Papipapito/MSXgoauldSD_usbkb/README.md

# MSXgoauldSD_usbkb — MSX Goa'uld with USB keyboard & joystick

Fork of **[jabadiagm/MSXgoauldSD_tn20k](https://github.com/jabadiagm/MSXgoauldSD_tn20k)** — the FPGA "Z80-socket replacement" that turns a real MSX into an MSX2+ on a Tang Nano 20K — adding a **USB keyboard and a USB joystick/gamepad** that work **alongside** the MSX's own keyboard and joysticks, through a **Raspberry Pi Pico / RP2040** over a single UART wire. Everything the MSX already does (real keyboard, joysticks, cartridges, SD, WiFi) keeps working; the USB devices are *merged in*, not a replacement.

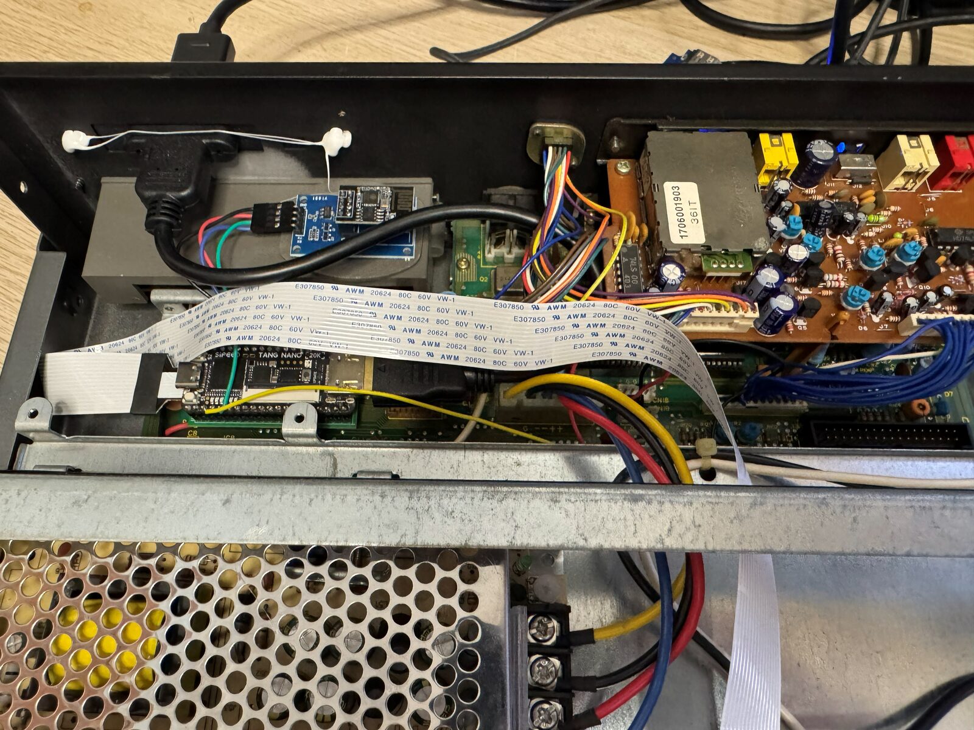
[picture p1: pics/goauld_usbkb_in_msx.jpg]
The Goa'uld board (Tang Nano 20K) installed in a real MSX, with the ESP-01S WiFi module


*The Goa'uld board (Sipeed **Tang Nano 20K**) sitting in a real MSX's Z80 socket, with the **ESP-01S WiFi** module and HDMI output. The USB keyboard and joystick reach the FPGA over the single wire to Tang pin 75 — the MSX's own keyboard and joysticks keep working at the same time.*

▶️ **See it running on a real MSX:**

MSXgoauldSD_usbkb — USB keyboard on a real MSX (video) (https://youtube.com/shorts/J3gg5tnaye4)

**Derived from the great work of:**
- **jabadiagm** — MSX Goa'uld: the FPGA MSX2+ core and board. <https://github.com/jabadiagm/MSXgoauldSD_tn20k>
- **Chandler-Klüser** — MSX Goa'uld *Guardian Angel*: the RP2040 USB-host firmware (based on the No0ne / pdaxrom HID parser). <https://github.com/Chandler-Kluser/msx-goauld-ga>
- **Ryan Wendland (Ryzee119)** — `tusb_xinput`, the TinyUSB XInput host driver (MIT). <https://github.com/Ryzee119/tusb_xinput>

**License:** GPLv3 (inherited). The vendored `tusb_xinput` driver keeps its MIT header.

## Features
- **USB keyboard** alongside the physical MSX keyboard — **US / International** layout, non-blocking make/break, modifiers (Shift/Ctrl/Graph/Code).
- **USB joystick / gamepad** merged with the real MSX joysticks — **generic HID *and* XInput (Xbox)** pads.
- **One data wire**: RP2040 → FPGA over UART (Tang Nano pin 75). The joystick needs no extra pins (same link).
- **WS2812 status LED** on the RP2040 (red / green / yellow / white), plus an optional external 8-LED status panel.
- **Turbo** — internal high-speed CPU, toggled from the boot menu, **F11**, or the Panasonic `$40/$41` I/O ports.
- **WiFi (ESP-01S)** ready in the FPGA core (optional).
- Real keyboard, joysticks, slots and cartridges are untouched.

## How it works
The Goa'uld board replaces the MSX's Z80, so the FPGA sits on the real system bus. It does **not** re-implement the keyboard/joystick ports — the real motherboard scans them and the FPGA just *watches* the bus. The RP2040 runs a TinyUSB **host**, reads the USB keyboard + gamepad, and sends keyboard **make/break** events (plus a periodic full-matrix resync) and a **joystick byte** (`0xB0 <port> <state>`) over UART. Inside the FPGA these are **AND-merged** (active-low) into the MSX keyboard-matrix read and the PSG joystick read, so the **USB and the real devices coexist** — use either, both reach the MSX.

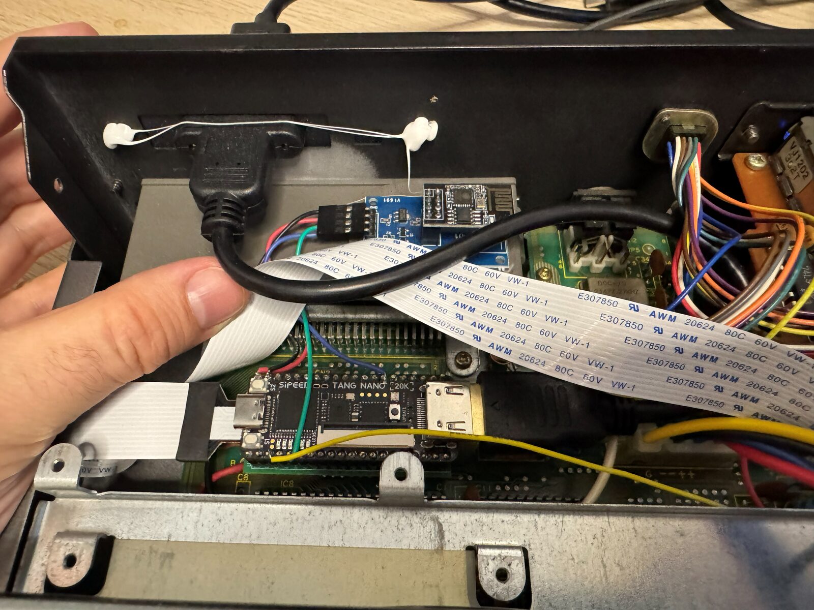
[picture p2: pics/goauld_usbkb_tang_hdmi.jpg]
Close-up of the Tang Nano 20K with HDMI output and the ESP-01S WiFi module


*Close-up: the **Tang Nano 20K** (HDMI out, USB-C) and the **ESP-01S WiFi** module, connected to the Z80 socket by the ribbon cable.*

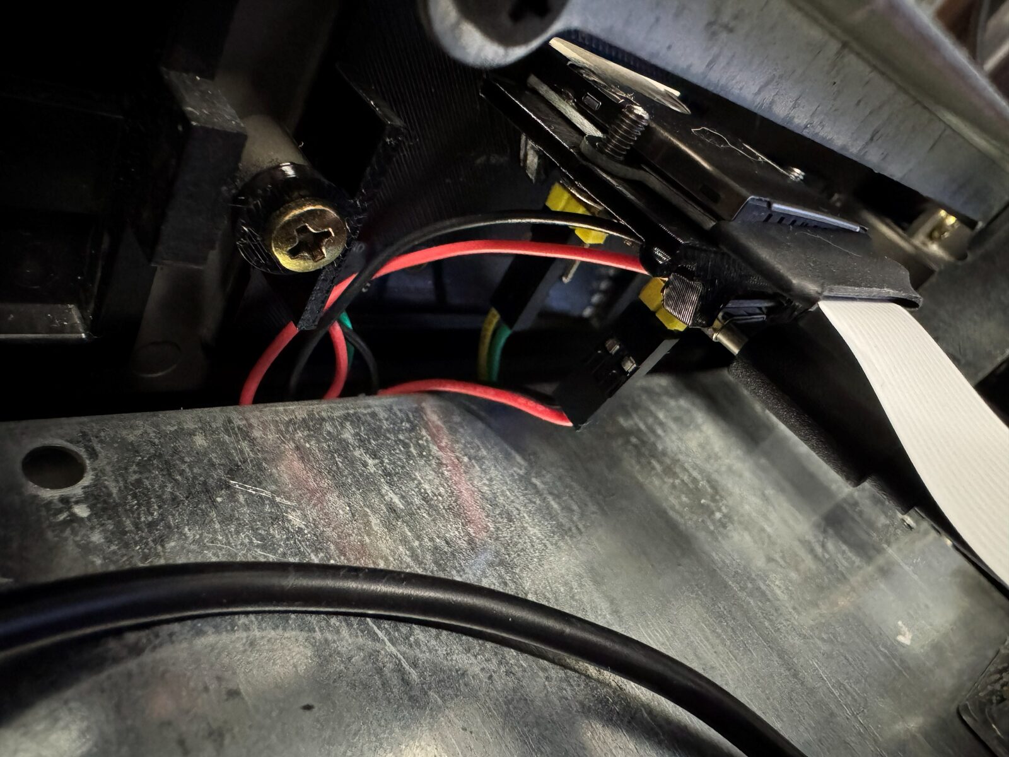
[picture p3: pics/goauld_usbkb_rp2040_leds.jpg]
The RP2040-Zero and the back of the case's front LED panel


*The **RP2040-Zero** (running the USB keyboard/joystick firmware) and the rear of the case's **front LED status panel** (the WS2812 strip).*

## Binaries (see [Releases](../../releases) or [`production/`](production/))
| File | What it is |
|---|---|
| `MSXgoauldSD_usbkb.fs` | FPGA bitstream (Tang Nano 20K, GW2AR-18) with the keyboard + joystick merge. |
| `rp2040_keyboard.uf2` | RP2040 firmware — **Waveshare RP2040-Zero** (on-board WS2812 LED on GPIO16). |

> The release ships the **RP2040-Zero** firmware. A plain **Raspberry Pi Pico** build (mono LED on GPIO25) can be built from source with `-DRP2040_ZERO=0`. Both drive the optional external 8-LED WS2812 panel on **GP26** (see *Status LEDs*).

## Version guard (keep the three flashables in step)
Since **v1.2**, the bitstream, the RP2040 firmware and the BIOS pack all carry the **same BCD version** (e.g. `0x13` = v1.3) and the **FPGA verifies it**:

- **`.fs`** — `FPGA_VERSION` in [`fpga/top.v`](fpga/top.v).
- **`.uf2`** — `FW_VERSION` in [`rp2040/inc/usbin.h`](rp2040/inc/usbin.h); the RP2040 announces it over the UART link (`0xC0 <ver>`, re-sent with every 250 ms resync — old bitstreams simply ignore it).
- **BIOS pack** — the **last byte** of the 512 KB pack (offset `0x7FFFF`, flash `0x27FFFF`); the FPGA latches it while loading the pack at boot. Packs that predate v1.2 read `0xFF` there.

**Automatic warning (no software needed):** if the versions do **not** match — e.g. you flash a new `.fs` but keep an old BIOS pack, or run a firmware from another version — the FPGA paints a **thick red border around the screen** while the machine runs. It disappears as soon as all three match. The RP2040 is optional: with **no Pico connected** there is **no border** (only a *mismatched* Pico or an *old pack* triggers it).

For scripted checks, the FPGA also exposes everything on I/O ports **0x2E/0x2F** (reads are served by the FPGA only; same `0x2F` convention as MSXnano):

| Access | Returns |
|---|---|
| `IN &H2F` | FPGA version (e.g. `&H13`) |
| `OUT &H2F,0` then `IN &H2E` | RP2040 firmware version (`0` = not announced / link down) |
| `OUT &H2F,1` then `IN &H2E` | BIOS pack version byte (`&HFF` = pre-v1.2 pack) |
| `OUT &H2F,2` then `IN &H2E` | **Verify status: `0` = everything matches**; bit0 = uf2 mismatch, bit1 = uf2 not announced, bit2 = pack mismatch, bit3 = pack has no version |

Quick check from MSX-BASIC:
```basic
OUT &H2F,2 : IF INP(&H2E)=0 THEN PRINT "VERSIONS OK" ELSE PRINT "MISMATCH! ";INP(&H2E)
```
When releasing, bump `FPGA_VERSION`, `FW_VERSION` and the pack byte **together**.

## Status LEDs (WS2812)

### On-board LED (RP2040-Zero)
A single WS2812 showing one **priority** colour:
| Colour | Meaning |
|---|---|
| 🔵 Blue blink (3×) at power-up | Firmware booted OK |
| 🔴 Solid red | Alive — nothing connected |
| 🟢 Solid green | USB **keyboard** connected |
| 🟡 Solid yellow | USB **gamepad** connected |
| ⚪ White flash | Key press / joystick activity |

### Optional external 8-LED panel (on the case)
An 8× WS2812 stick mounted on the case turns the status into a **panel where each LED is a different signal** (instead of one colour). Driven from **RP2040 GP26**; the on-board LED keeps working alongside it.

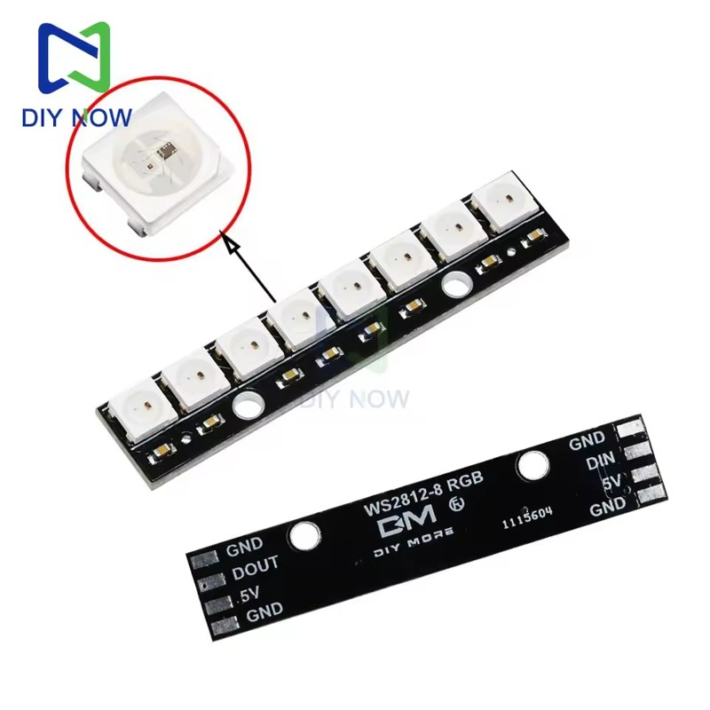
[picture p4: pics/ws2812_8_strip.jpg]
WS2812-8 RGB strip


**Board:** a generic **WS2812-8 RGB** stick (8 × WS2812 / NeoPixel on a PCB) — e.g. [AliExpress (product 1005009810895755)](https://www.aliexpress.com/item/1005009810895755.html).

**Pinout** — two pad rows; **use the `DIN` side** (the `DOUT` side just chains a second strip):

| Side | Pads |
|---|---|
| **Input (use this)** | `GND` · **`DIN`** · `5V` · `GND` |
| Output (chain) | `GND` · `DOUT` · `5V` · `GND` |

**Wiring** — the strip is rated **4–7 VDC**:
```
RP2040 GP26  ->  strip DIN    (3.3 V data, direct -- no level shifter)
common GND   ->  strip GND
MSX +5V --|>|-   strip 5V      one 1N4007 silicon diode -> ~4.3 V (inside the
                               4-7 V range). The strip's VIH (~0.7*Vcc) then sits
                               below 3.3 V, so it reads the RP2040's 3.3 V data.
                               5 V direct often works too -- add the diode only
                               if the colours glitch.
```

**What each LED means** — LED **0** is the one nearest the `DIN` connector:

| # | Colour | Signal |
|---|---|---|
| 0 | 🔴 red | **Power** — system on (always lit) |
| 1 | 🔵 blue | USB **keyboard** detected |
| 2 | 🟡 yellow | USB **gamepad** detected |
| 3 | ⚪ white | **Typing** — flashes on key press |
| 4 | 🟢 green | **Fire A** / button 1 (blinks at 10 Hz while autofiring) |
| 5 | 🟣 magenta | **Fire B** / button 2 (blinks at 10 Hz while autofiring) |
| 6 | 🩵 cyan | **Direction** — any joystick movement |
| 7 | 💚 dim green | **Heartbeat** (~1 Hz, shows the firmware is alive) |

> To change the data pin, the LED order or the colours, edit `STRIP_PIN` / the `f[...]` lines in [`rp2040/src/main.c`](rp2040/src/main.c). `STRIP_LEDS` defaults to 8.

## Flashing (both files)
1. **FPGA** — Gowin Programmer → load `MSXgoauldSD_usbkb.fs` into the Tang Nano 20K (SRAM for a quick test, or the external config flash to persist). Your BIOS pack at `0x200000` is untouched.
2. **RP2040** — hold **BOOTSEL**, plug USB-C → the `RPI-RP2` drive appears → copy `rp2040_keyboard.uf2` onto it. The blue boot blink = it's running.

## USB keyboard
**US / International** layout (matches the international MSX2+ BIOS). Letters, digits and arrows are 1:1 with the MSXnano translator; a few symbols depend on your board's BIOS. The MSX BIOS does autorepeat and the FPGA owns the matrix, so the RP2040 never blocks.

## USB joystick / gamepad
Plug a **wired** USB pad into the RP2040 (use a **powered** USB hub if you also want the keyboard at the same time). Mapped to **MSX joystick port 1**: D-pad / hat / left stick → directions, **A / button 1 → fire 1 (trigger A)**, **B / button 2 → fire 2 (trigger B)**. The two spare buttons (3 / 4) act as **autofire** for fire 1 / fire 2.
- **XInput** — Xbox 360 / One / Series and XInput-mode pads (via the bundled `tusb_xinput` driver). ✅ tested on hardware.
- **Generic HID** — pads exposing standard X/Y axes, a hat and buttons (many retro / arcade / SNES-style USB pads).
- **Keyboard + joystick at once** need a **powered** USB hub — the RP2040-Zero has a single USB port. Since v1.3 an XInput pad runs **input-only** (rumble / LED are disabled): its extra interrupt-OUT endpoint otherwise overwhelms the RP2040's native USB host behind a hub and stops both devices from working.
- **Limitations:** wireless **2.4 GHz dongles** usually can't be enumerated by the RP2040's lightweight USB host (they signal late, after the pad pairs) → use a **wired** controller; some **DualShock 4 / PS-mode** pads use a report format the basic HID parser doesn't decode yet → use the pad in **XInput mode** if it has one.

## Turbo (high-speed CPU)
The core has an internal **high-speed CPU clock** — jabadiagm's ~6.75 MHz turbo, derived from the video clock so it stays stable at boot, in the menu and in MSX-DOS. Since **v1.3** there are **three ways** to toggle it, all acting on the same state:

- **Boot menu** — the *Turbo* option (press **G** during the MSX logo).
- **F11** — toggles turbo **live** at any moment, from the USB keyboard.
- **Panasonic switched-I/O ports `$40/$41`** (device 8, WSX-style) so existing MSX turbo software works unchanged:
  ```basic
  OUT &H40,8 : PRINT INP(&H40)  ' select device 8; returns 247 (detection)
  OUT &H41,0                    ' turbo ON   (bit0 active-low)
  OUT &H41,1                    ' turbo OFF
  ' INP(&H41) = 250 (&HFA) turbo / 251 (&HFB) normal
  ```

> Turbo runs the CPU faster than real-MSX timing; some timing-sensitive software may misbehave — use it for SD / MSX-DOS work and games that tolerate it.

## Wiring (one data wire + ground + 5 V)

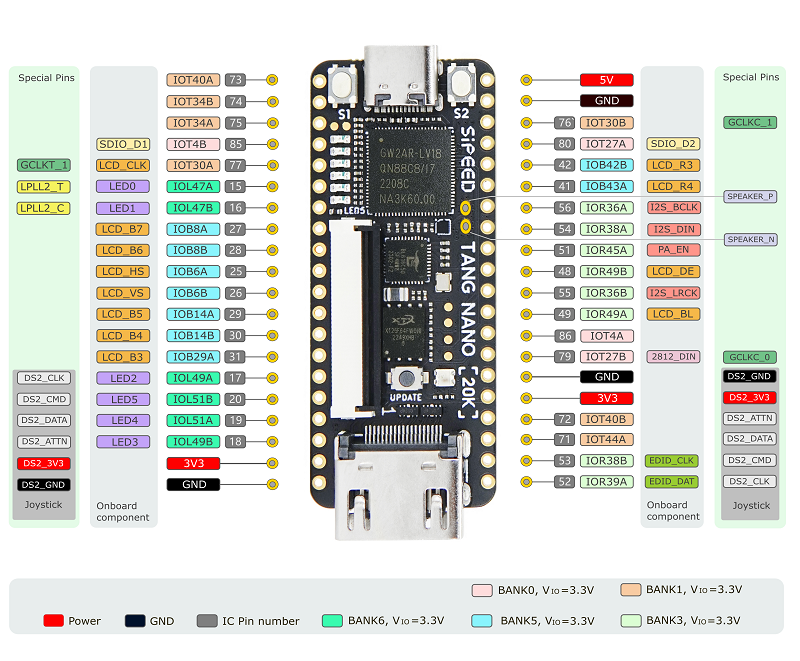
[picture p5: pics/tang_nano_20k_pinout.png]
Tang Nano 20K pinout


*Tang Nano 20K pin labels — image © [Sipeed](https://wiki.sipeed.com/hardware/en/tang/tang-nano-20k/nano-20k.html).* **The pins this fork uses:**

| Tang Nano 20K pin | Used for | Direction |
|---|---|---|
| 🟢 **75** | RP2040 keyboard **+ joystick** link | RP2040 GP15 (PIO-UART TX) → FPGA |
| 🔵 **77** | WiFi — ESP-01S (optional) | ESP TX → FPGA |
| 🔵 **79** | WiFi — ESP-01S (optional) | FPGA → ESP RX |
| ⚫ **GND** | Common ground (required) | — |
| 🔴 **5V** | Power | MSX +5 V → RP2040 / ESP |

```
RP2040 GP15 (PIO-UART TX) ->  Tang Nano 20K pin 75
RP2040 GND                ->  Tang Nano 20K GND   (common ground, required)
RP2040 VBUS / 5V          ->  MSX +5V
USB keyboard / gamepad    ->  RP2040 USB host port (use a powered hub for both at once)
```
UART **115200 8N1**, data flows RP2040 → FPGA only; 3.3 V LVCMOS both ends (no level shifter). Since v1.3 the link is driven from **GP15** via a PIO UART (the LED strip uses GP26, GP27 is free) — the RP2040's hardware UARTs don't reach GP15.

### WiFi (ESP-01S, optional)
The core ships with the MSX UNAPI WiFi driver. Wire an **ESP-01S**: TX → **pin 77**, RX → **pin 79**, VCC + CH_PD → **3.3 V**, GND → GND. Firmware: the **OCM** build of **[ducasp / MSX-Development ESPFW1.4](https://github.com/ducasp/MSX-Development/releases/tag/ESPFW1.4)**; baud **859372**, I/O ports **0x06 / 0x07**. It coexists with the RP2040 (pin 75).

## Building from source
- **FPGA:** open `Z80_goauld.gprj` in Gowin EDA, run synthesis + place-and-route → `MSXgoauldSD_usbkb.fs`. The USB logic is in [`fpga/src/kbd_uart_rx.v`](fpga/src/kbd_uart_rx.v) and the bus merge in [`fpga/top.v`](fpga/top.v).
- **RP2040:** standard pico-sdk build in [`rp2040/`](rp2040/) — `cmake -B build && cmake --build build`. Set `PICO_SDK_PATH` to your pico-sdk; pass `-DRP2040_ZERO=0` for a plain Pico.

The MSX **BIOS pack** and any third-party module firmware are **not** distributed here (copyright).

---

# MSXgoauldSD_tn20k
MSX Goa'uld board with Tang Nano 20k and SD support

V1.5_SMD

MSX2+ engine in Z80 socket. It turns one MSX into an MSX2+ by replacing Z80 processor. FPGA in board contains: 
* Z80
* V9958 with hdmi output
* MSX2+ BIOS
* SD Card support + Nextor 2.1
* 4MB mapper
* 2MB megaram SCC
* RTC
* PSG
* OPLL
* Kanji Level 1 & 2
* Wifi support using ESP (experimental)

## Boards

Old boards V1.4 and V4.1 are compatible with Goa'uld SD. V3 is not supported, owners of V3 should use Goa'uld standard firmware (0.80).

New pcb V1.5 is same as 1.4, optimized for online PCB assembly. See [Assembly guide](/pcba/pcba.md)

## Slot map

Slot map

Mapper and megaram can be relocated to slots 1 or 2 using config menu.

## Megaram + Sofarun
Megaram is detected automatically by sofarun using default settings. When using other software you may need to indicate location, Slot 3-3 by default.

## Configuration
Config menu is showed pressing g during MSX logo. New improved menu is created by [nataliapc](https://github.com/nataliapc/msx_goauld_settings_menu)

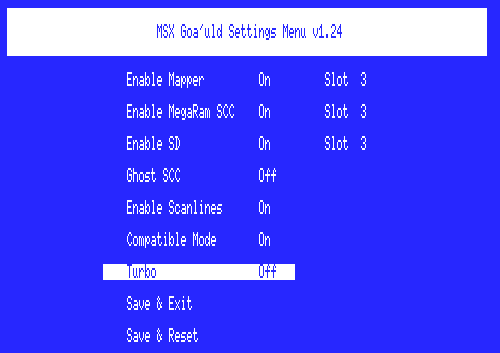
[picture p6: pics/config6.png]
Config


* Enable Mapper: On by default. Disable when having compatibility issues or to use a different mapper
* Enable Megaram: On by default. Disable when having compatibility issues or to use a different megaram
* Enable SD: On by default. Disable when using an external SD mapper
* Mapper Slot: 3 by default. Change to 1 or 2 to get mapper in a not expanded slot. Physical slot will be disabled
* Megaram Slot: 3 by default. Change to 1 or 2 to get megaram in a not expanded slot. Physical slot will be disabled
* Ghost SCC: Off by default. Enable to get sound from an SCC cartridge located in physical slot 1 or 2
* Enable Scanlines: On by default. Disable to get a clean hdmi picture
* Compatible Mode: On by default. Enable for use with external cartridges
* Turbo: Off by default. Enable to use an internal high-speed clock. Recommended for internal SD use only
* Save & Exit: store new config and continue, changes in mapper settings will be effective after pressing reset
* Save & Reset: store new config and make software reset, changes will be immediate

## Known issues
* Reset from config menu is not compatible with some hardware. Use physical reset button when possible
* Tape games fail: use poke -1,0
* Carnivore C2+ and Megaflashrom SCC+ SD are not compatible with Compatible mode (yes, I know)
* Wifi unreliable: place ESP at appropiate distance from Tang

## Flashing
Programming is done in two steps:
* Flash firmware Z80_goauld.fs  

Flash1a
Flash1b
* Flash bios pack. Set Operation = "exFlash C Bin Erase, Program thru GAO-Bridge" and Start Address = 0x200000  

Flash2a
Flash2b

> [!WARNING]
> Not yet fully working on all MSX!
>
