Papipapito/MSXgoauldSD_usbkb/(commit log)

2026-05-29 feat(usb-kbd): FPGA virtual-matrix merge + RP2040 event-driven keyboard
    FPGA: new kbd_uart_rx.v (UART 115200 8N1 RX + decoder + active-low vkey_matrix); merged into the 0xA9 keyboard read via active-low AND at the cpu_din mux (read-only, never drives the bus); 0xAA row-select snoop; RX on pin 75; single clk_54m domain; ~1s stuck-key watchdog.
    RP2040 (Guardian Angel rewrite): non-blocking event-driven make/break replacing the blocking 40ms-per-key model; derived Shift/Ctrl/Graph/Code modifiers; US keymap from MSXnano coords + keypad/Caps/grave; 250ms full-matrix resync; dedicated uart0 (GPIO0). Build fixed (removed missing dialect.c, disabled stdio).
    Protocol: 0x90/0xA0 make/break, cell=0x8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
    [main.c, top.v]
2026-05-29 fix(usb-kbd): count-based D_LOAD resync (BUG-1) + correct 1-wire README wiring
    kbd_uart_rx.v: D_LOAD now stores all 11 rows by count instead of treating a data 0xFF as the terminator. 0xFF is the normal all-released row state (active-low), so the old early-out aborted nearly every 250ms resync, defeating the stuck-key self-heal. The trailing 0xFF terminator now lands in D_IDLE and is ignored.
    rp2040/README.md: replaced the stale 2-wire (pins 79/80) Guardian Angel wiring with the actual 1-wire scheme (RP2040 GPIO0 TX -> FPGA pin 75 RX + common GND); fixed the build command.
2026-05-29 fix(rp2040): build with arm-gcc (C label cannot precede a declaration)
    GA's hid_parse_report_descriptor had a declaration right after 'case RI_MAIN_FEATURE:', which arm-none-eabi-gcc 9.3.1 -std=gnu11 rejects ('a label can only be part of a statement'). Added an empty statement after the label so the following declaration is legal. Verified: the full firmware now compiles and links to goauld_friend.uf2 (picotool via MSVC host). Added .gitignore for FPGA/RP2040 build outputs.
2026-05-29 feat(rp2040): WS2812 status LED (boot / idle / kbd-mounted / keypress)
    RP2040-Zero on-board NeoPixel (GPIO16) now shows status via a PIO WS2812 driver (vendored ws2812.pio): blue blink on boot, slow blue heartbeat when idle, solid green when a USB keyboard is mounted, brief white flash on keypress. The inherited code drove the WS2812 with gpio_put() (no visible output). Pico build (-DRP2040_ZERO=0) keeps the mono GPIO25 LED. isMounted is now set by the HID mount/unmount callbacks; g_last_key_us timestamps each MAKE. Verified: compiles + links to goauld_friend.uf2.
2026-05-29 feat(rp2040): status LED solid red when no USB keyboard connected
    Idle state (no keyboard) changed from blue heartbeat to solid red, per request.
2026-05-29 feat(rp2040): runtime US<->ES layout toggle (one firmware) + LED indicator
    Replaces the compile-time KEYMAP_ES variant with a runtime g_layout, toggled by tapping PrintScreen (HID 0x46, unused on MSX). map_cell() applies the Spanish overrides at runtime; the status LED flashes cyan(US)/magenta(ES) ~0.6s on switch. One firmware now serves both layouts.
    [main.c]
2026-05-29 feat: USB HID joystick via RP2040, merged with the real MSX joystick
    FPGA: PSG-register snoop (0xA0 reg, 0xA1 reg15 port-select) + AND-merge at the 0xA2/reg14 read in the cpu_din mux; joystick byte received in kbd_uart_rx via new opcode 0xB0. Real MSX joystick + USB joystick coexist (active-low AND). RP2040: generic HID gamepad parser (X/Y axes thresholded, hat switch, buttons) reusing the existing HID descriptor parser, mapped to MSX port 1 (btn1->TrigA, btn2->TrigB), emitted as 0xB0 over the same UART/pin 75. No new pins/build/CDC. Verified: Gowin synth+pnr OK (project.fs) and pico-sdk build OK (goauld_friend.uf2).
2026-05-29 fix(rp2040): bigger HID enumeration buffer + gamepad status-LED diagnostics
    CFG_TUH_ENUMERATION_BUFSIZE 256->1024 so HID gamepads with large report descriptors enumerate (mount_cb was silently skipping them). Status LED: solid yellow = USB gamepad detected (no keyboard), white flash on joystick activity. Lets a user without a serial console see whether the RP2040 recognises the pad as generic-HID (yellow) or not (stays red = likely XInput). Work-in-progress on usb-keyboard; not promoted to main until HW-tested.
    [main.c]
2026-05-29 fix(rp2040): enum buffer 2048 + violet LED for skipped HID device
    User's pad is generic-HID (verified in MSXnano), not XInput. mount_cb skips any HID device whose report descriptor exceeds CFG_TUH_ENUMERATION_BUFSIZE (256 originally) -> LED stayed red. Raised to 2048 and added g_hid_skip_us: a violet (0x150028) LED flash when a device is skipped, so the cause is visible without a serial console. Diagnose: yellow=detected/fixed, violet=descriptor>2048 (bump more), red=not enumerated as HID at all.
    [main.c]
2026-05-29 diag(rp2040): USB device-level attach counter + blue LED to isolate power vs unsupported
    HID pad and an Xbox Series X pad both stay red with no violet -> they never reach tuh_hid_mount_cb. Added tuh_mount_cb/tuh_umount_cb (class-agnostic, fire for ANY enumerated device) feeding g_usb_dev_count, and a blue LED state = a USB device enumerated but no HID driver claimed it. Now: red = nothing enumerated (power/signal), blue = enumerated but not HID (XInput/vendor), yellow = HID gamepad OK, violet = HID descriptor too big. Distinguishes the user's power hypothesis from an unsupported-class device.
    [main.c]
2026-05-29 feat(rp2040): XInput host driver (Ryzee119 tusb_xinput, MIT) alongside HID
    Vendors xinput_host.c/.h (MIT; patched: open() returns bool for TinyUSB 0.18). Registered via usbh_app_driver_get_cb; tuh_xinput_mount/report/umount_cb feed the SAME joy_set_state (0xB0) path as the HID gamepad (dpad + left stick -> directions, A->TrigA, B->TrigB), set g_joy_mounted for the LED. CFG_TUH_XINPUT=1; xinput_host.c added to build. Covers Xbox 360/One/Series + 2.4GHz XInput-mode dongles that the HID host cannot claim. Also LED priority fix: a detected gamepad shows yellow before green. HID keyboard + HID gamepad paths untouched; builds clean.
    [main.c]
2026-05-29 chore(v1.1): US-only keyboard + HID/XInput joystick, full English README, binaries
    Removed the runtime Spanish layout (toggle, ES map_cell overrides) and the diagnostic LED states (blue=enumerated-unclaimed, violet=descriptor-too-big) plus their machinery (g_layout, g_usb_dev_count, g_hid_skip_us, tuh_mount/umount_cb). Keyboard is now US/International only; status LED = red(idle)/green(keyboard)/yellow(gamepad)/white(activity). README.md rewritten as full English docs. Production binaries (.uf2 + .fs) committed; the copyrighted BIOS pack and debug ELF are gitignored. Builds clean.
2026-05-29 docs: add Tang Nano 20K pinout image, marking the pins this fork uses
    Pinout diagram (c) Sipeed, with a legend table highlighting pin 75 (RP2040 keyboard+joystick), 77/79 (WiFi ESP-01S), GND and 5V.
2026-06-01 feat(rp2040): autofire/turbo on the two spare gamepad buttons
    While a turbo button is held, its fire bit is square-waved at 10 Hz
    (50 ms on / 50 ms off, 50% duty) so the MSX sees rapid shots. Each phase
    spans >=2 PSG frames so PAL/NTSC games never miss a toggle.
    Mapping (the two buttons we were not using):
    - HID : button 3 -> autofire fire1 (Trigger A), button 4 -> autofire fire2 (B)
    - XInput: X -> autofire A, Y -> autofire B (A/B stay manual fire1/fire2)
    No protocol change: only toggles the existing JOY_A/JOY_B bits over the
    frozen 0xB0 link; the FPGA is untouched.
    - The two report callbacks stop emitting and instead latch two intent
    layers per port: joy_base (dirs + manual fire) and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
2026-06-06 feat(rp2040): external 8-LED WS2812 status strip on GPIO1
    Drives a daisy-chained WS2812 strip mounted on the case as a status bar,
    mirroring the on-board status LED colour (red idle / green keyboard /
    yellow gamepad / white activity, + blue boot blink).
    - New PIO state machine (pio0 SM1) on STRIP_PIN=GPIO1, reusing the same
    ws2812 program already loaded for the on-board NeoPixel (SM0) -- no
    CMake change. strip_rgb() fills all STRIP_LEDS (8) with one colour.
    - strip_init() after status_led_init(); boot blink and the main-loop
    status update now drive both the on-board LED and the strip.
    - Works on RP2040-Zero (on-board on SM0 GP16 + strip on SM1 GP1) and on a
    plain Pico (strip loads t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
2026-06-06 fix(rp2040): move LED strip data to GPIO14 (easier to solder)
    GP14 is a bottom-edge castellated pad on the RP2040-Zero, more convenient
    for soldering the case-strip connector than GP1. STRIP_PIN 1 -> 14; no
    other change (still pio0 SM1, mirrors the status LED). Untested on HW.
    [main.c]
2026-06-06 feat(rp2040): 8-LED case strip as a per-LED status panel
    Instead of all 8 LEDs showing the same colour, each LED is a distinct
    signal (GP14 strip):
    [0] power red (always on)
    [1] keyboard blue (USB keyboard mounted)
    [2] joystick yellow(USB gamepad mounted)
    [3] typing white (flashes on key press)
    [4] fire A green (button A / fire1; blinks at 10Hz when autofiring)
    [5] fire B magenta (button B / fire2; blinks at 10Hz when autofiring)
    [6] move cyan (any joystick direction)
    [7] heartbeat dim green (~1Hz, shows the firmware is alive)
    Exposes three new signals from usbin.c for the panel:
    - g_kbd_mounted : keyboard-specific mount flag (set/recomputed in the HID
    key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
2026-06-06 docs: document the external 8-LED WS2812 case panel
    Add a "Status LEDs" section covering the on-board LED and the optional
    external WS2812-8 RGB strip: the board, its DIN/DOUT pinout, wiring for the
    4-7V strip (GP14 data + 1N4007 diode -> ~4.3V), and the per-LED colour map
    (power/keyboard/joystick/typing/fireA/fireB/direction/heartbeat). Image
    referenced at pics/ws2812_8_strip.png (to be added).
2026-07-02 build(rp2040): ship a prebuilt plain-Pico UF2 (rp2040_keyboard_pico.uf2)
    Same firmware built with -DRP2040_ZERO=0 in a separate build_pico/ dir
    (gitignored): mono LED on GP25 instead of the Zero on-board NeoPixel.
    The external 8-LED WS2812 case panel works identically on both boards --
    data on GP14 (Pico physical pin 19). READMEs updated with the new binary
    and the GP14 note.
2026-07-02 feat: version guard -- .fs / .uf2 / BIOS pack carry one version, FPGA verifies
    All three flashables now embed the same BCD version (0x12 = v1.2), modeled
    on the MSXnano v1.9 version register (port 0x2F = 0x19):
    - .fs: FPGA_VERSION localparam in top.v.
    - .uf2: FW_VERSION in usbin.h, announced over the UART link as 0xC0 <ver>
    with every 250 ms resync (kbd_uart_rx gains a D_VERSION state; additive,
    old bitstreams ignore the opcode; cleared by the 1 s link watchdog).
    - pack: version byte = LAST byte of the 512KB pack (offset 0x7FFFF, flash
    0x27FFFF), latched by the flash loader FSM as it streams the pack at boot
    (loader covers it: GOAULD_ROM_SIZE = 512KB+6). Pre-v1.2 packs read 0xFF.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
2026-07-02 feat(fpga): red-border on-screen warning when versions mismatch
    The version guard now WARNS automatically, no software needed: when the
    .fs / .uf2 / BIOS-pack versions do not match, the FPGA paints a 40px red
    border around the HDMI picture.
    - top.v: version_mismatch = (pack loaded AND != FPGA_VERSION) OR (uf2
    announced AND != FPGA_VERSION). Excludes 0x00 so there is no false red
    at boot (pack not yet loaded) and none when no RP2040 is connected
    (the Pico is optional). Wired into v9958_top vdp4.
    - v9958_top.v: new version_mismatch input; paints red at the visible edges
    using the HDMI raster (cx<720 && cy<screen_height, hdmi.sv). 40px thick
    to survive TV overscan. Zero effect when v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
2026-07-04 feat(fpga): swap jabadiagm 6.75 turbo for our Panasonic-WSX 5.37 MHz
    Kept the 0.93 turbo toggle (config menu -> config_enable_turbo -> turbo_safe)
    and the CPU clock mux; only replaced the cadence the mux selects in turbo:
    6.75 MHz (video-dot-derived) -> our MSXnano /20-on-108MHz + 1/176 period
    swallow = EXACT WSX 5.369318 Hz (HW-validated on MSXnano, chosen for game
    compatibility over the faster 6.75). gw_sh: 0 errors, 0 timing violations.
    [top.v]
2026-07-06 feat(rp2040): move FPGA link to GP15 (PIO UART) and LED strip to GP26
    Carrier redesign for the RP2040-Zero support needs the external signals on
    GP15/GP26 (GP27 left free). The FPGA keyboard/joystick link was a hardware
    uart0 on GP0, but the RP2040 HW UART TX can only reach GP0/12/16/28 -- so it
    is now a PIO UART TX on GP15 (new rp2040/uart_tx.pio, pio1 SM0), same 115200
    8N1 wire protocol to Tang Nano pin 75. WS2812 case strip STRIP_PIN 14 -> 26
    (pio0 SM1, unchanged otherwise). Builds clean for both RP2040-Zero and plain
    Pico variants.
    [main.c]
2026-07-07 fix(usb): key hid_info[] by (dev_addr,instance) so keyboard+joystick coexist
    TinyUSB numbers HID `instance` per-device (0-based), so a USB keyboard and a
    USB joystick are two separate devices that both enumerate as instance 0. The
    code indexed hid_info[instance] directly, so the second device clobbered the
    first's parsed report descriptor in hid_info[0]: with both connected, each read
    the other's descriptor and did nothing. XInput pads use a separate driver and
    never touch hid_info[], which is why an Xbox pad + keyboard coexisted but a
    generic HID joystick + keyboard did not.
    Map every (dev_addr,instance) to its own hid_info[] slot (alloc on mount, free
    on unmount) and route mount/report/ga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
2026-07-07 fix(xinput): drop LED/rumble OUT transfers so an XInput pad is interrupt-IN-only
    The joystick is an Xbox 360-clone (XInput) with rumble. tuh_xinput_mount_cb
    issued three BLOCKING interrupt-OUT transfers at mount (2x set_led + set_rumble).
    Behind a USB hub on the RP2040 native host these arm a second hub-split interrupt
    endpoint that the single SIE cannot poll concurrently with the keyboard's
    interrupt-IN: the pad's first report never arrives (not detected) and the wedged
    OUT poisons the shared SIE, killing the keyboard too. Rumble/LED are cosmetic and
    unused by the MSX joystick path, so drop them and keep the pad interrupt-IN-only
    (matching a keyboard). Mitigation for the RP2040 hub limitati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
2026-07-07 feat(turbo): Panasonic-WSX 5.37MHz exact (M1 wait in turbo) + $40/$41 ports; v1.3
    FPGA (top.v):
    - Add per-M1 wait synthesized for turbo (ported from MSXnano v1.9). At 3.58 the
    1-wait-per-M1 brake comes from the MSX board via bus_wait_n; in turbo the CPU
    free-runs at 5.37 and bus_wait_n is bypassed, so without this the 5.4MHz clock
    benched ~6.17 instead of 5.37. wait_m1 masks exactly one CPU-clock period per M1
    opcode fetch, armed only when turbo_safe=1 (3.58 mode untouched).
    - Add Panasonic switched-I/O device 8 (ports 40/41): OUT 40h,8 selects; IN 40h=247;
    OUT 41h bit0 active-low (0=5.37,1=3.58) latched into config2_ff[4] (same bit as
    the menu G toggle); IN 41h=FAh/FBh. pana_dou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
2026-07-07 fix(turbo): revert per-M1 wait -- it destabilizes the goauld external-bus turbo
    The wait_m1 (to make turbo bench exactly 5.37 like standalone MSXnano) caused
    erratic CPU (~180MHz bench), hang, and corrupted VDP logo on HW: the goauld drives
    the REAL MSX bus with a stretch FSM (wait_addr + bus isolation), and an extra
    per-M1 clock-enable mask desyncs the enable/falling pairing. Reverted to the stable
    turbo (real ~5.4MHz clock, benches ~6.17 only because no M1 wait is inserted).
    Panasonic $40/$41 software control and version 0x13 are kept. Exact-5.37-bench
    needs reworking the bus-stretch timing (upstream/jabadiagm's domain).
    [top.v]
2026-07-07 feat(turbo): F11 live turbo toggle (kbd cmd 0x04) alongside menu + Panasonic
    F11 previously mapped to command 0x01 (scanline), which the FPGA decoded but left
    unconnected (no-op). Remap F11 (HID 0x44) -> command 0x04 in keymaps.h; kbd_uart_rx
    decodes 0x04 to a new cmd_turbo_toggle pulse; top.v wires it and flips config2_ff[4]
    (turbo) on each press. Turbo now has 3 controls on the same bit: boot menu (G), F11
    live, and Panasonic $40/$41. Only the RP2040-Zero uf2 is shipped (Pico dropped).
    Synthesis clean, 0 timing violations.
    [top.v]
2026-07-08 fix(turbo): force wait FSMs idle in turbo (turbo+wait was unstable)
    Turbo + 'modo compatible' (config_enable_wait, config2_ff[3]) went to erratic
    speeds on HW: the goauld wait_io/wait_addr FSMs were tuned for jabadiagm's 6.75MHz
    turbo and desync with our 5.4MHz Panasonic cadence. 'compatible OFF + turbo' (wait
    FSMs idle) is stable ~5.4MHz (bench 6.17), so gate both wait FSMs on
    (config_enable_wait & ~config_enable_turbo): turbo always runs wait-idle regardless
    of the menu wait bit; 3.58 (non-turbo) keeps the real-MSX waits unchanged. Makes
    F11/menu/Panasonic turbo stable in either compatible-mode setting. 0 timing viol.
    [top.v]
2026-07-08 fix(turbo): force turbo OFF at boot -- never boot into turbo (anti-brick)
    Persisting turbo (menu) booted the system straight into turbo, where the boot/menu
    ROM and DOS/Nextor init hang (blue screen, menu unreachable) -- recoverable only by
    reflashing a turbo-off pack. Clear config2_ff[4] on config_init in both the s2 and
    persisted paths so the system ALWAYS powers on at 3.58; turbo is enabled per-session
    via F11 / Panasonic $41 (works in DOS). Combined with the turbo-forces-wait-idle fix,
    turbo can no longer brick the boot. 0 timing violations.
    [top.v]
2026-07-08 fix(turbo): restore jabadiagm 0.93 video-derived 6.75MHz turbo (stable at boot)
    Root cause of the turbo boot/menu hang: our 5.37 Panasonic cadence was free-running
    (/20 of clk_108m), ASYNC to the VDP dot clock, so VDP-heavy boot/menu code hung at
    turbo. jabadiagm's 6.75 turbo is derived from VideoDHClk/VideoDLClk (13.5MHz/2) --
    locked to the VDP -- so it is stable at boot, in the menu and in DOS, and turbo+wait
    works (the wait FSMs were tuned for it). Repoint the turbo mux back to clk_6m75_* and
    revert both crutches (turbo-forces-wait-idle 0e9d4f0, force-off-at-boot c8d3a9b) which
    are no longer needed. Keep the menu G / F11 / Panasonic $40-$41 turbo controls and
    version 0x13. 5.37 is unreach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
    [top.v]
2026-07-08 docs(readme): update for v1.3 (English)
    - Turbo section: menu / F11 / Panasonic $40-$41 controls (jabadiagm 6.75MHz)
    - Turbo added to the feature list
    - Pins: FPGA link GP15 (PIO-UART), LED strip GP26, GP27 free
    - Version guard examples 0x12 -> 0x13
    - Binaries: ship RP2040-Zero uf2; Pico is a from-source build
    - Joystick: keyboard+joystick need a powered hub; XInput runs input-only (v1.3)
2026-07-12 docs(readme): fix 3rd photo caption — it's the RP2040-Zero + LED panel rear, not HDMI
